JEly613/FPGA-Logic-Analyzer/sims/README.md

## Digital Channel Structure

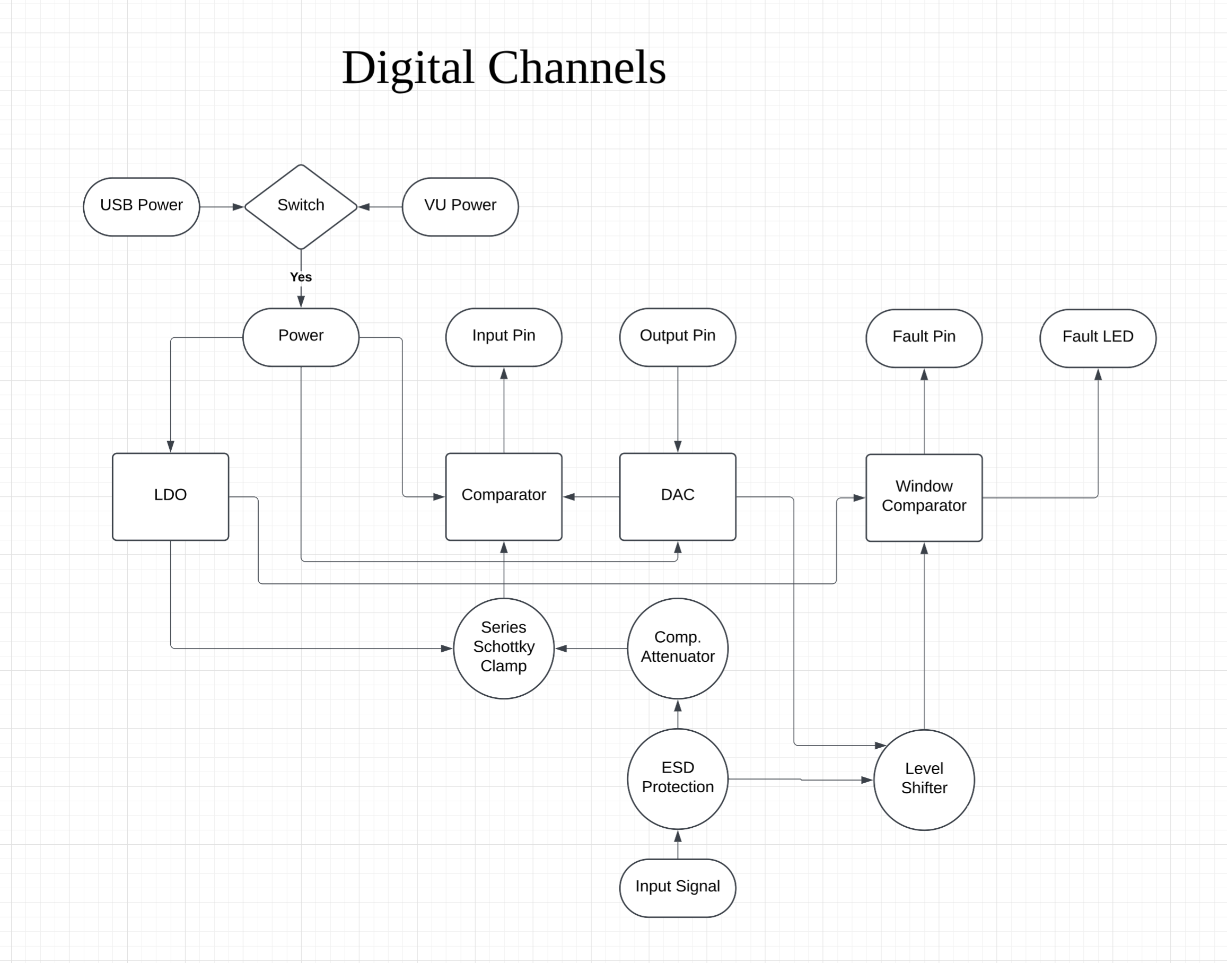
[picture p1: sims/image-2.png]


## Compensated Attenuator

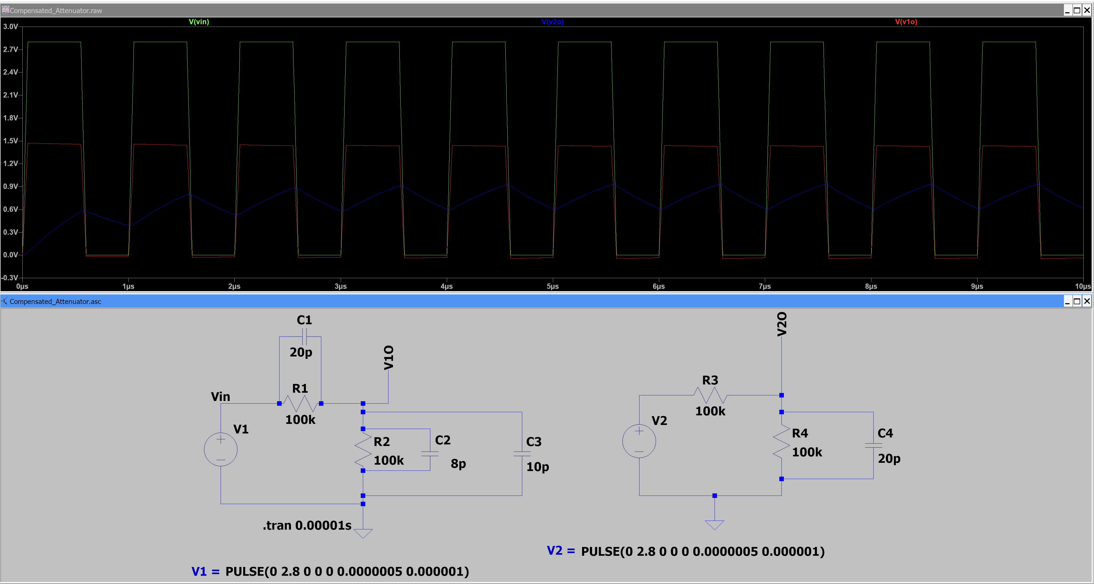
[picture p2: sims/image-4.png]


## Series Clamp

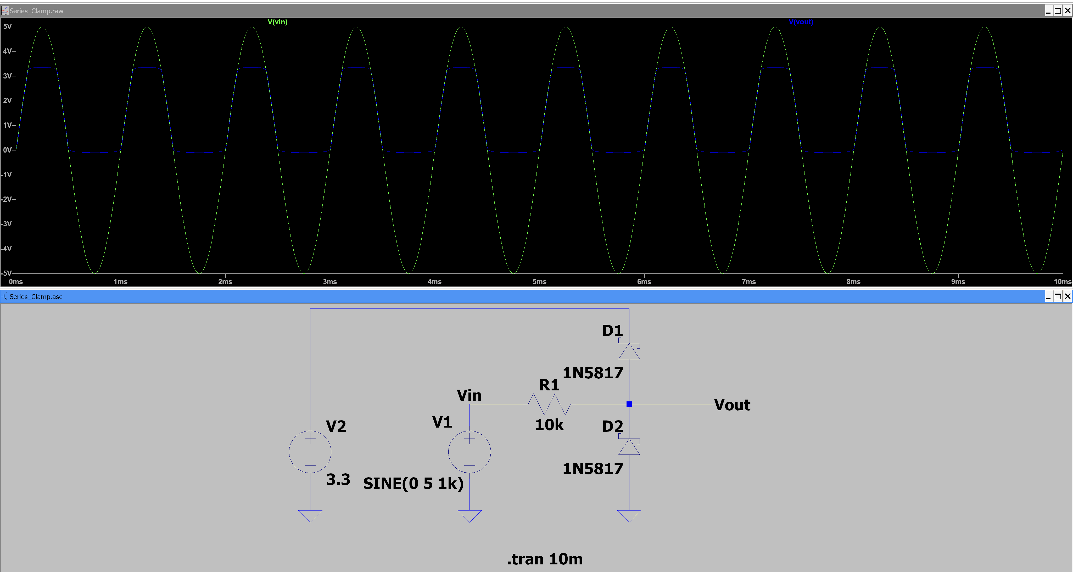
[picture p3: sims/image.png]


## Fault Detection

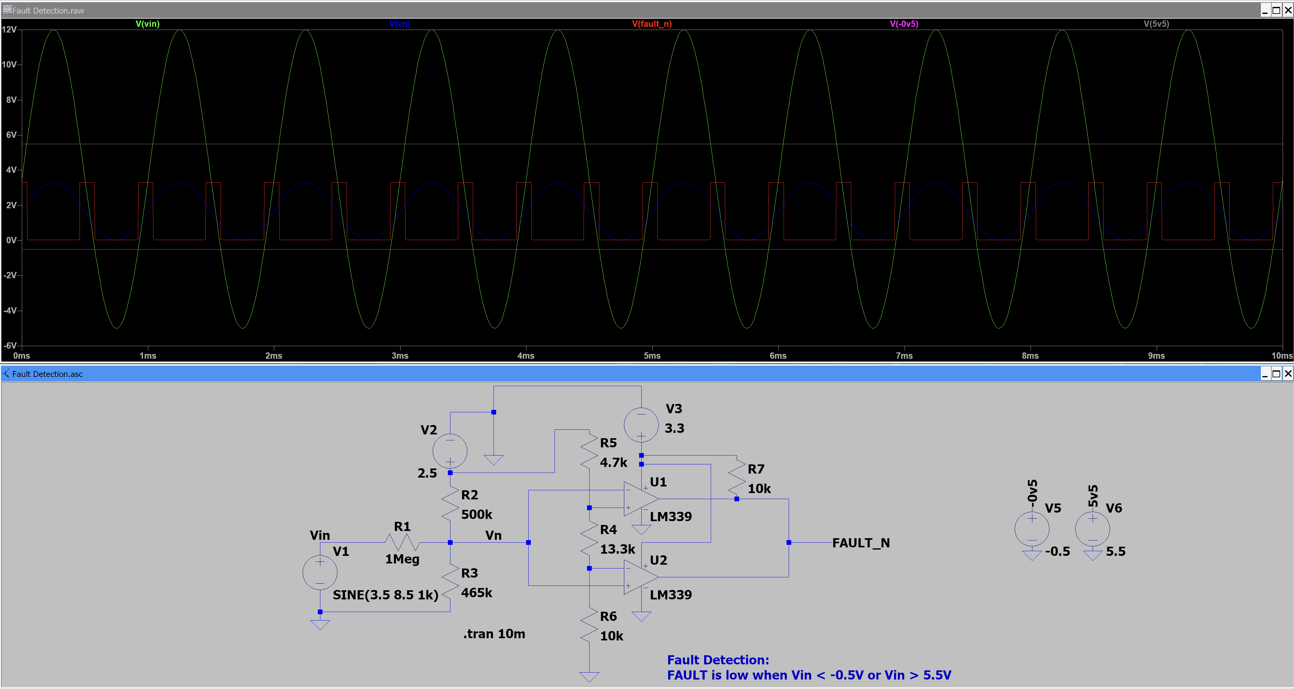
[picture p4: sims/image-1.png]
