JEly613/FPGA-Logic-Analyzer/sims/image-3.png

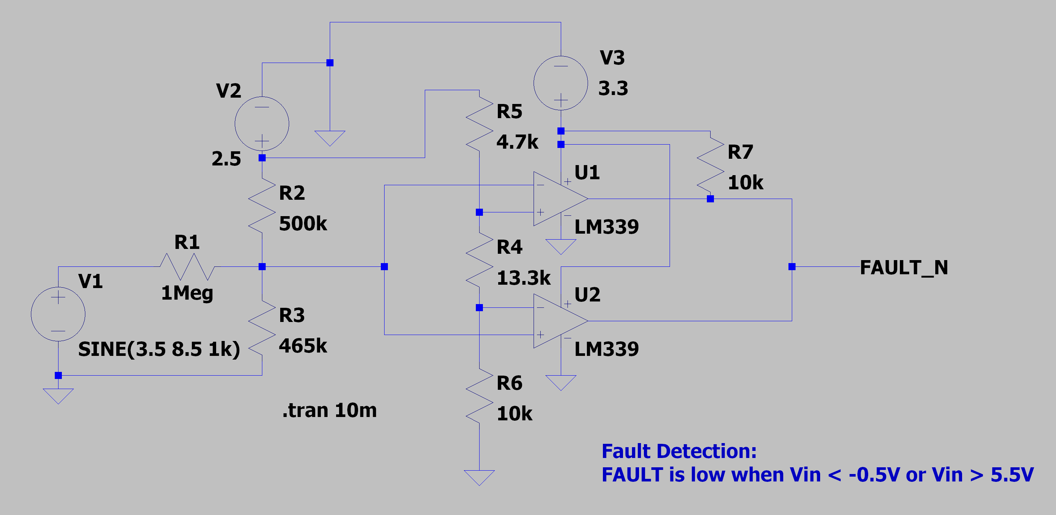
sims/image-3.png
