JEly613/FPGA-Logic-Analyzer/pcb/Analog_Front_End/AFE_3dmodels/JZ100.stp

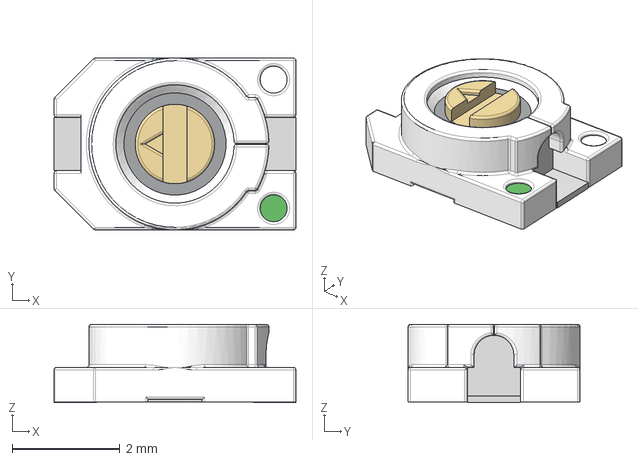
[picture p7: CAD file, 2026-10-25]
pcb/Analog_Front_End/AFE_3dmodels/JZ100.stp
4.50 x 3.20 x 1.46 mm
