JEly613/FPGA-Logic-Analyzer/sims/Op_amp_testing.asc

R1: res; 10k
R2: res; 10k
U2: OP400
V1: voltage; 50
V2: voltage; 2
Named nets: 0
.tran 0 1ms 0
