JEly613/FPGA-Logic-Analyzer/sims/AFE Testing.asc

C1: cap; 20p
C2: cap; 8p
C3: cap; 10p
C4: cap; 20p
R1: res; 100k
R2: res; 100k
R3: res; 100k
R4: res; 100k
V1: voltage; PULSE(0 2.8 0 0 0 0.0000005 0.000001)
V2: voltage; PULSE(0 2.8 0.0000003 0 0 0.0000005 0.000001)
Named nets: 0
.tran 0.00001s
