JEly613/FPGA-Logic-Analyzer/sims/Fault Detection.asc

R1: res; 1Meg
R2: res; 500k
R3: res; 465k
R4: res; 13.3k
R5: res; 4.7k
R6: res; 10k
R7: res; 10k
U1: LM339
U2: LM339
V1: voltage; SINE(3.5 8.5 1k)
V2: voltage; 2.5
V3: voltage; 3.3
V5: voltage; -0.5
V6: voltage; 5.5
Named nets: 0, FAULT_N, Vin, Vn, -0v5, 5v5
.tran 10m
Fault Detection:
FAULT is low when Vin < -0.5V or Vin > 5.5V
