JEly613/FPGA-Logic-Analyzer/sims/Series_Clamp.asc

D1: schottky; 1N5817
D2: schottky; 1N5817
R1: res; 10k
V1: voltage; SINE(0 5 1k)
V2: voltage; 3.3
Named nets: 0, Vin, Vout
.tran 10m
