JEly613/FPGA-Logic-Analyzer/pcb/Analog_Front_End/Analog_Front_End.kicad_pcb

## KiCad design pcb/Analog_Front_End/Analog_Front_End.kicad_pcb (2026-11-10)

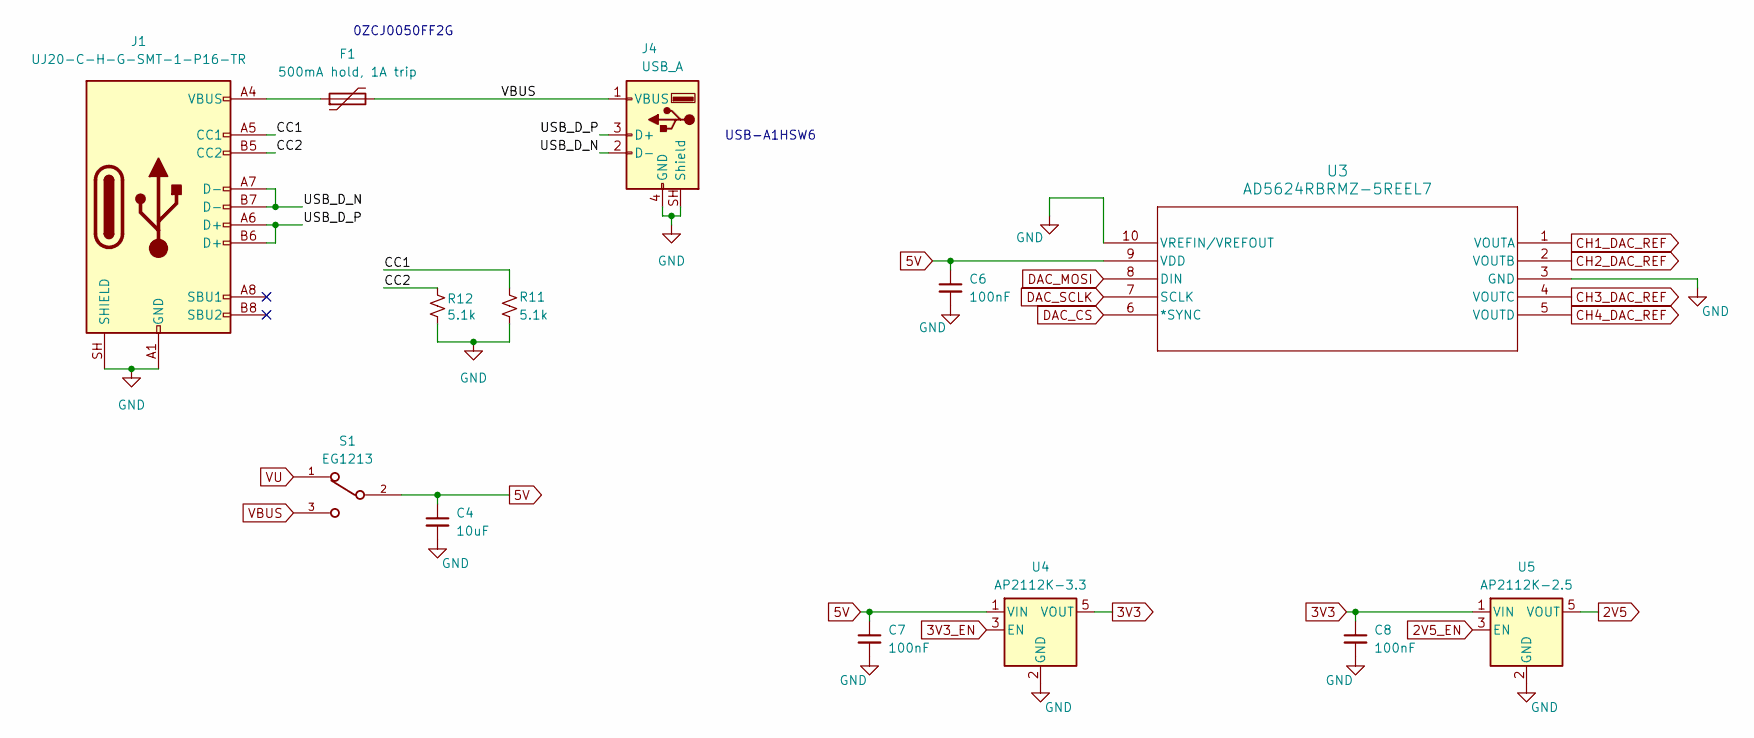
[picture p8: schematic PWR.kicad_sch]

Parts:
C4: 10uF; C_0603_1608Metric_Pad1.08x0.95mm_HandSolder
C6, C7, C8: 100nF; C_0603_1608Metric_Pad1.08x0.95mm_HandSolder
F1: 500mA hold, 1A trip; Fuse_1206_3216Metric_Pad1.42x1.75mm_HandSolder
J1: UJ20-C-H-G-SMT-1-P16-TR; SAMESKY_UJ20-C-H-G-SMT-1-P16-TR
J4: USB_A; CONN_USB-A1HSW6_OST
R11, R12: 5.1k; R_0603_1608Metric_Pad0.98x0.95mm_HandSolder
S1: EG1213; SW_EG1213; DigiKey_Part_Number EG1906-ND
U3: AD5624RBRMZ-5REEL7; RM_10_ADI-L
U4: AP2112K-3.3; SOT-23-5
U5: AP2112K-2.5; SOT-23-5

Connections:
2V5: U5.5 (VOUT); also elsewhere on the board
2V5_EN: U5.3 (EN); also elsewhere on the board
3V3: C8.1, U4.5 (VOUT), U5.1 (VIN); also elsewhere on the board
3V3_EN: U4.3 (EN); also elsewhere on the board
5V: C4.1, C6.1, C7.1, S1.2, U3.9 (VDD), U4.1 (VIN); also elsewhere on the board
/PWR/CC1: J1.A5 (CC1), R11.2
/PWR/CC2: J1.B5 (CC2), R12.2
/PWR/USB_D_N: J1.A7 (D-), J1.B7 (D-), J4.2 (D-)
/PWR/USB_D_P: J1.A6 (D+), J1.B6 (D+), J4.3 (D+)
CH1_DAC_REF: U3.1 (VOUTA); also elsewhere on the board
CH2_DAC_REF: U3.2 (VOUTB); also elsewhere on the board
CH3_DAC_REF: U3.4 (VOUTC); also elsewhere on the board
CH4_DAC_REF: U3.5 (VOUTD); also elsewhere on the board
DAC_CS: U3.6 (*SYNC); also elsewhere on the board
DAC_MOSI: U3.8 (DIN); also elsewhere on the board
DAC_SCLK: U3.7 (SCLK); also elsewhere on the board
GND: C4.2, C6.2, C7.2, C8.2, J1.A1 (GND), J1.A12 (GND), J1.B1 (GND), J1.B12 (GND), J1.SH (SHIELD), J4.4 (GND), J4.SH (Shield), R11.1, R12.1, U3.3 (GND), U3.10 (VREFIN/VREFOUT), U4.2 (GND), U5.2 (GND); also elsewhere on the board
unnamed: F1.1, J1.A4 (VBUS), J1.A9 (VBUS), J1.B4 (VBUS), J1.B9 (VBUS)
VBUS: F1.2, J4.1 (VBUS), S1.3
VU: S1.1; also elsewhere on the board

Notes on the sheet:
0ZCJ0050FF2G
USB-A1HSW6

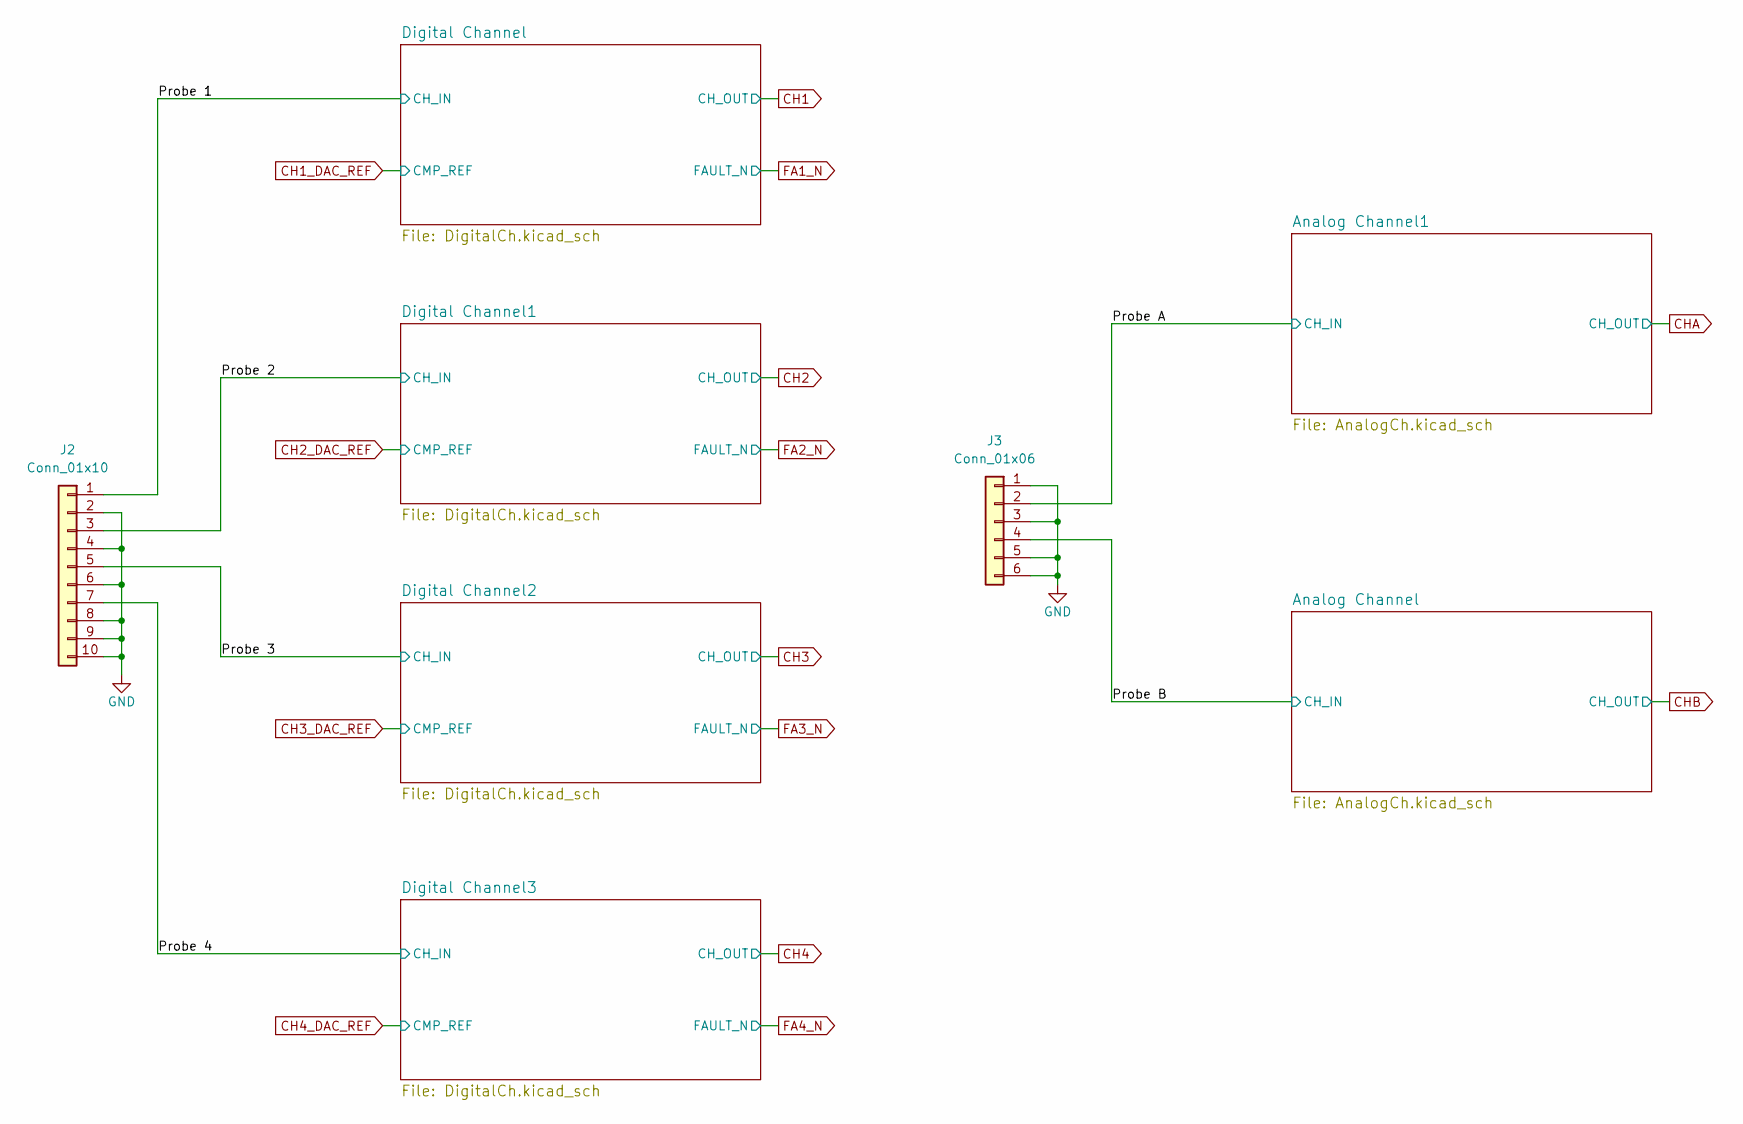
[picture p9: schematic AFE.kicad_sch]

Parts:
J2: Conn_01x10; BoxHeader_2x05_P2.54mm_Horizontal
J3: Conn_01x06; BoxHeader_2x03_P2.54mm_Horizontal

Connections:
/AFE/Probe 1: J2.1; also elsewhere on the board
/AFE/Probe 2: J2.3; also elsewhere on the board
/AFE/Probe 3: J2.5; also elsewhere on the board
/AFE/Probe 4: J2.7; also elsewhere on the board
/AFE/Probe A: J3.2; also elsewhere on the board
/AFE/Probe B: J3.4; also elsewhere on the board
GND: J2.2, J2.4, J2.6, J2.8, J2.9, J2.10, J3.1, J3.3, J3.5, J3.6; also elsewhere on the board

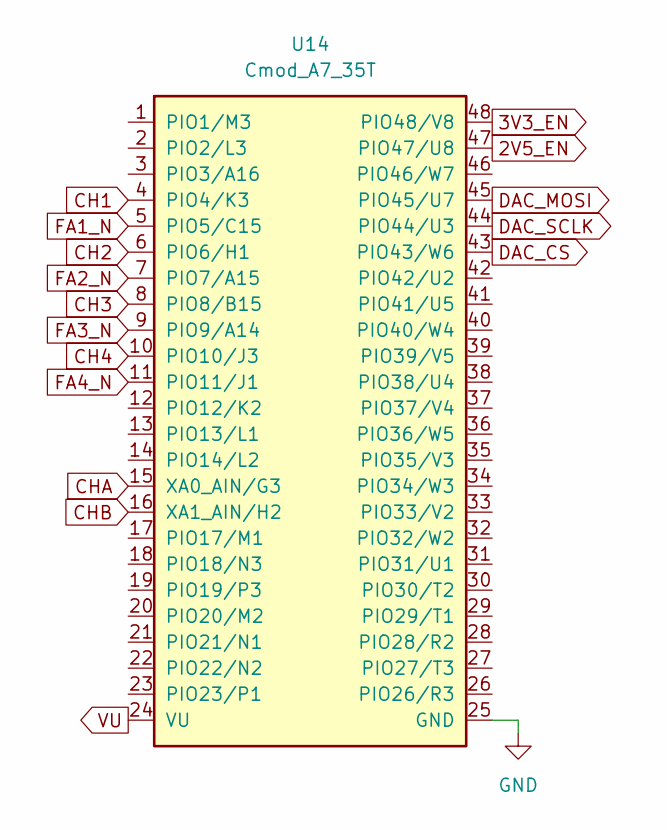
[picture p10: schematic FPGA.kicad_sch]

Parts:
U14: Cmod_A7_35T; Cmod_A7_DIP48_W15.24mm_Socket; MPN 410-328-35

Connections:
2V5_EN: U14.47 (PIO47/U8); also elsewhere on the board
3V3_EN: U14.48 (PIO48/V8); also elsewhere on the board
CH1: U14.4 (PIO4/K3); also elsewhere on the board
CH2: U14.6 (PIO6/H1); also elsewhere on the board
CH3: U14.8 (PIO8/B15); also elsewhere on the board
CH4: U14.10 (PIO10/J3); also elsewhere on the board
CHA: U14.15 (XA0_AIN/G3); also elsewhere on the board
CHB: U14.16 (XA1_AIN/H2); also elsewhere on the board
DAC_CS: U14.43 (PIO43/W6); also elsewhere on the board
DAC_MOSI: U14.45 (PIO45/U7); also elsewhere on the board
DAC_SCLK: U14.44 (PIO44/U3); also elsewhere on the board
FA1_N: U14.5 (PIO5/C15); also elsewhere on the board
FA2_N: U14.7 (PIO7/A15); also elsewhere on the board
FA3_N: U14.9 (PIO9/A14); also elsewhere on the board
FA4_N: U14.11 (PIO11/J1); also elsewhere on the board
GND: U14.25 (GND); also elsewhere on the board
VU: U14.24 (VU); also elsewhere on the board

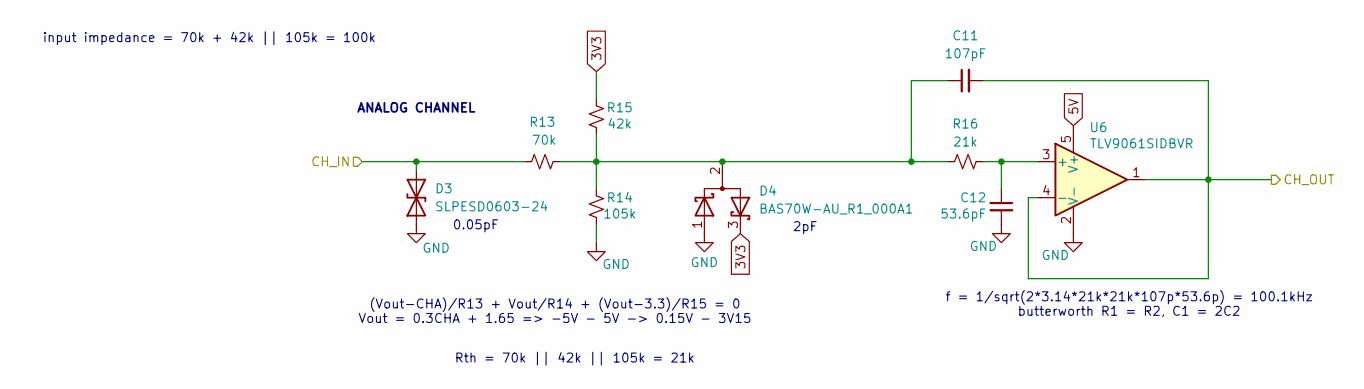
[picture p11: schematic AnalogCh.kicad_sch]

Parts:
C11: 107pF; C_0603_1608Metric_Pad1.08x0.95mm_HandSolder
C12: 53.6pF; C_0603_1608Metric_Pad1.08x0.95mm_HandSolder
D3: SLPESD0603-24; D_0603_1608Metric_Pad1.05x0.95mm_HandSolder
D4: BAS70W-AU_R1_000A1; SOT-323_SC-70
R13: 70k; R_0603_1608Metric_Pad0.98x0.95mm_HandSolder
R14: 105k; R_0603_1608Metric_Pad0.98x0.95mm_HandSolder
R15: 42k; R_0603_1608Metric_Pad0.98x0.95mm_HandSolder
R16: 21k; R_0603_1608Metric_Pad0.98x0.95mm_HandSolder
U6: TLV9061SIDBVR; SOT-23-5

Connections:
3V3: D4.3 (K), R15.1; also elsewhere on the board
5V: U6.5 (V+); also elsewhere on the board
/AFE/Probe B: D3.2 (A2), R13.1; also elsewhere on the board
CHB: C11.2, U6.1, U6.4 (-); also elsewhere on the board
GND: C12.2, D3.1 (A1), D4.1 (K), R14.2, U6.2 (V-); also elsewhere on the board
unnamed: C11.1, D4.2 (A), R13.2, R14.1, R15.2, R16.1
unnamed: C12.1, R16.2, U6.3 (+)

Parts of its further copies:
C23: 107pF; C_0603_1608Metric_Pad1.08x0.95mm_HandSolder
C24: 53.6pF; C_0603_1608Metric_Pad1.08x0.95mm_HandSolder
D11: SLPESD0603-24; D_0603_1608Metric_Pad1.05x0.95mm_HandSolder
D12: BAS70W-AU_R1_000A1; SOT-323_SC-70
R47: 70k; R_0603_1608Metric_Pad0.98x0.95mm_HandSolder
R48: 42k; R_0603_1608Metric_Pad0.98x0.95mm_HandSolder
R49: 105k; R_0603_1608Metric_Pad0.98x0.95mm_HandSolder
R50: 21k; R_0603_1608Metric_Pad0.98x0.95mm_HandSolder
U13: TLV9061SIDBVR; SOT-23-5

Connections of its further copies:
3V3: D12.3 (K), R48.1; also elsewhere on the board
5V: U13.5 (V+); also elsewhere on the board
/AFE/Probe A: D11.2 (A2), R47.1; also elsewhere on the board
CHA: C23.2, U13.1, U13.4 (-); also elsewhere on the board
GND: C24.2, D11.1 (A1), D12.1 (K), R49.2, U13.2 (V-); also elsewhere on the board
unnamed: C23.1, D12.2 (A), R47.2, R48.2, R49.1, R50.1
unnamed: C24.1, R50.2, U13.3 (+)

Notes on the sheet:
Rth = 70k || 42k || 105k = 21k
ANALOG CHANNEL
2pF
0.05pF
f = 1/sqrt(2*3.14*21k*21k*107p*53.6p) = 100.1kHz butterworth R1 = R2, C1 = 2C2
(Vout-CHA)/R13 + Vout/R14 + (Vout-3.3)/R15 = 0 Vout = 0.3CHA + 1.65 => -5V - 5V -> 0.15V - 3V15
input impedance = 70k + 42k || 105k = 100k

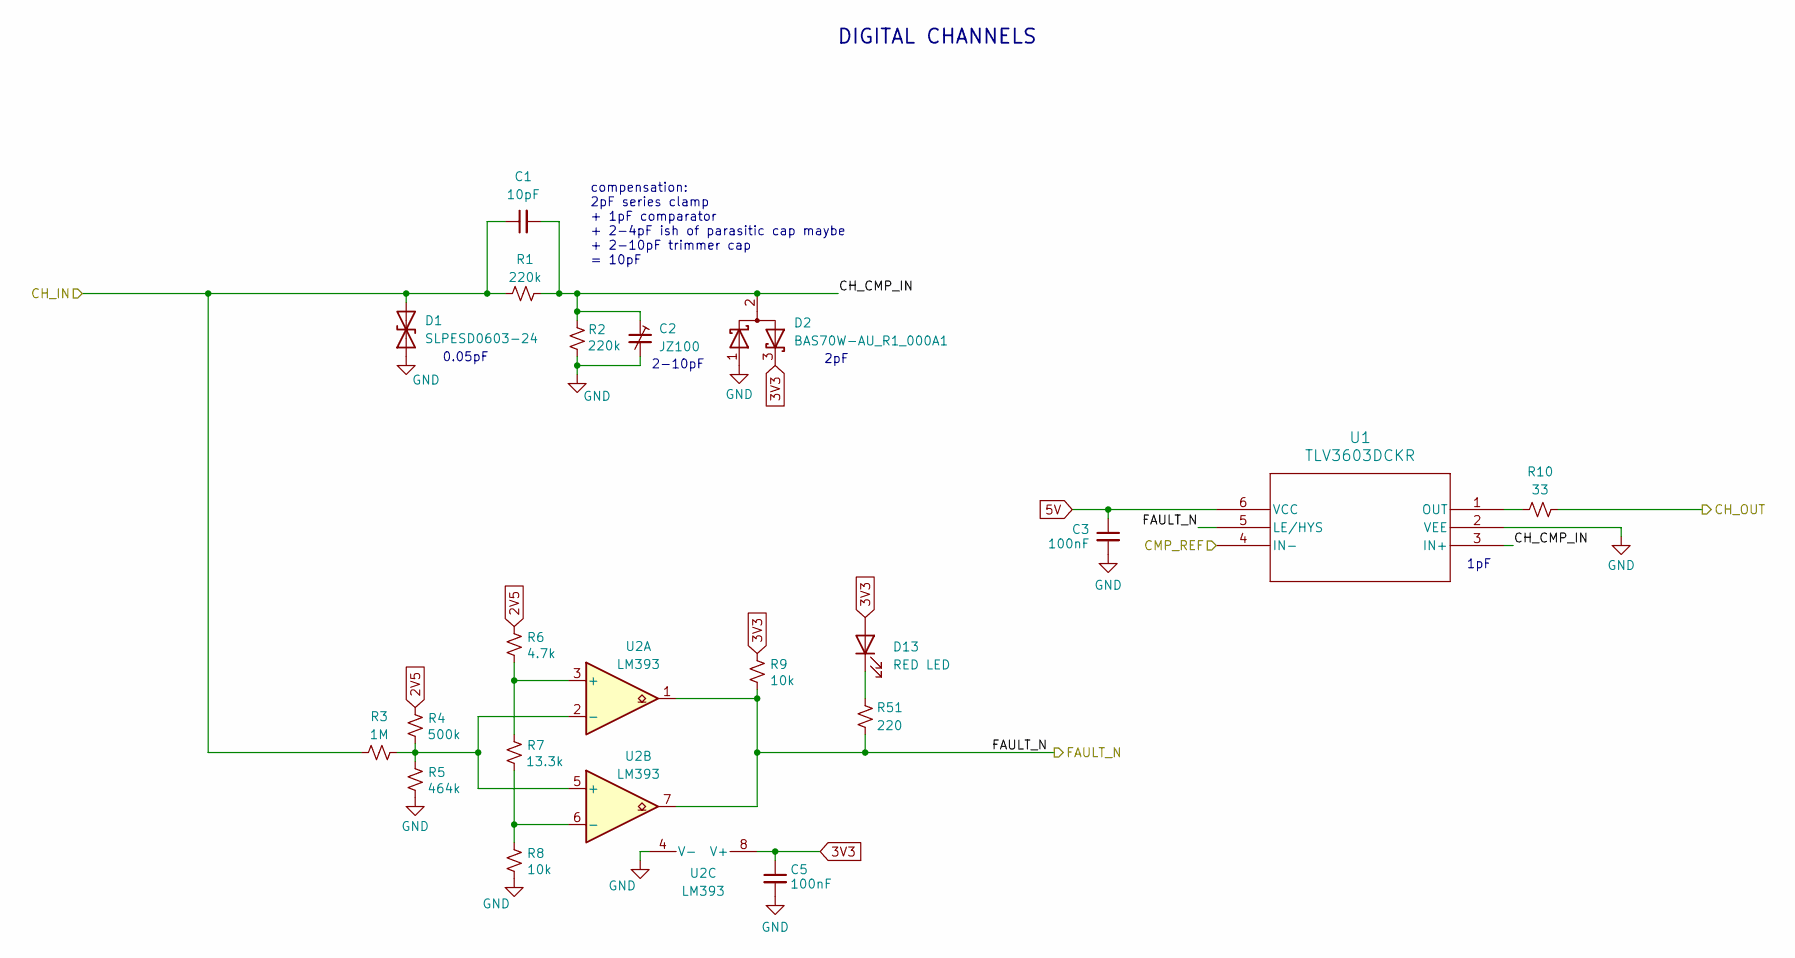
[picture p12: schematic DigitalCh.kicad_sch]

Parts:
C1: 10pF; C_0603_1608Metric_Pad1.08x0.95mm_HandSolder
C2: JZ100; C_0603_1608Metric_Pad1.08x0.95mm_HandSolder
C3, C5: 100nF; C_0603_1608Metric_Pad1.08x0.95mm_HandSolder
D1: SLPESD0603-24; D_0603_1608Metric_Pad1.05x0.95mm_HandSolder
D2: BAS70W-AU_R1_000A1; SOT-323_SC-70
D13: RED LED; LED_0805_2012Metric_Pad1.15x1.40mm_HandSolder
R1, R2: 220k; R_0603_1608Metric_Pad0.98x0.95mm_HandSolder
R3: 1M; R_0603_1608Metric_Pad0.98x0.95mm_HandSolder
R4: 500k; R_0603_1608Metric_Pad0.98x0.95mm_HandSolder
R5: 464k; R_0603_1608Metric_Pad0.98x0.95mm_HandSolder
R6: 4.7k; R_0603_1608Metric_Pad0.98x0.95mm_HandSolder
R7: 13.3k; R_0603_1608Metric_Pad0.98x0.95mm_HandSolder
R8, R9: 10k; R_0603_1608Metric_Pad0.98x0.95mm_HandSolder
R10: 33; R_0603_1608Metric_Pad0.98x0.95mm_HandSolder
R51: 220; R_0603_1608Metric_Pad0.98x0.95mm_HandSolder
U1: TLV3603DCKR; SC70_DCK_TEX
U2: LM393; LM393-L

Connections:
2V5: R4.1, R6.1; also elsewhere on the board
3V3: C5.1, D2.3 (K), D13.2 (A), R9.1, U2.8 (V+); also elsewhere on the board
5V: C3.1, U1.6 (VCC); also elsewhere on the board
/AFE/Digital Channel/CH_CMP_IN: C1.2, C2.1, D2.2 (A), R1.2, R2.1, U1.3 (IN+)
/AFE/Probe 1: C1.1, D1.2 (A2), R1.1, R3.1; also elsewhere on the board
CH1: R10.2; also elsewhere on the board
CH1_DAC_REF: U1.4 (IN-); also elsewhere on the board
FA1_N: R9.2, R51.2, U1.5 (LE/HYS), U2.1, U2.7; also elsewhere on the board
GND: C2.2, C3.2, C5.2, D1.1 (A1), D2.1 (K), R2.2, R5.2, R8.2, U1.2 (VEE), U2.4 (V-); also elsewhere on the board
unnamed: D13.1 (K), R51.1
unnamed: R10.1, U1.1 (OUT)
unnamed: R6.2, R7.1, U2.3 (+)
unnamed: R3.2, R4.2, R5.1, U2.2 (-), U2.5 (+)
unnamed: R7.2, R8.1, U2.6 (-)

Parts of its further copies:
C9, C15, C19: 10pF; C_0603_1608Metric_Pad1.08x0.95mm_HandSolder
C10, C16, C20: JZ100; C_0603_1608Metric_Pad1.08x0.95mm_HandSolder
C13, C14, C17, C18, C21, C22: 100nF; C_0603_1608Metric_Pad1.08x0.95mm_HandSolder
D5, D7, D9: SLPESD0603-24; D_0603_1608Metric_Pad1.05x0.95mm_HandSolder
D6, D8, D10: BAS70W-AU_R1_000A1; SOT-323_SC-70
D14, D15, D16: RED LED; LED_0805_2012Metric_Pad1.15x1.40mm_HandSolder
R17, R27, R37: 1M; R_0603_1608Metric_Pad0.98x0.95mm_HandSolder
R18, R28, R38: 500k; R_0603_1608Metric_Pad0.98x0.95mm_HandSolder
R19, R29, R39: 464k; R_0603_1608Metric_Pad0.98x0.95mm_HandSolder
R20, R30, R40: 4.7k; R_0603_1608Metric_Pad0.98x0.95mm_HandSolder
R21, R31, R41: 13.3k; R_0603_1608Metric_Pad0.98x0.95mm_HandSolder
R22, R25, R32, R35, R42, R45: 10k; R_0603_1608Metric_Pad0.98x0.95mm_HandSolder
R23, R24, R33, R34, R43, R44: 220k; R_0603_1608Metric_Pad0.98x0.95mm_HandSolder
R26, R36, R46: 33; R_0603_1608Metric_Pad0.98x0.95mm_HandSolder
R52, R53, R54: 220; R_0603_1608Metric_Pad0.98x0.95mm_HandSolder
U7, U9, U11: LM393; LM393-L
U8, U10, U12: TLV3603DCKR; SC70_DCK_TEX

Connections of its further copies:
2V5: R18.1, R20.1, R28.1, R30.1, R38.1, R40.1; also elsewhere on the board
3V3: C13.1, C17.1, C21.1, D6.3 (K), D8.3 (K), D10.3 (K), D14.2 (A), D15.2 (A), D16.2 (A), R25.1, R35.1, R45.1, U7.8 (V+), U9.8 (V+), U11.8 (V+); also elsewhere on the board
5V: C14.1, C18.1, C22.1, U8.6 (VCC), U10.6 (VCC), U12.6 (VCC); also elsewhere on the board
/AFE/Digital Channel1/CH_CMP_IN: C9.2, C10.1, D6.2 (A), R23.2, R24.1, U8.3 (IN+)
/AFE/Digital Channel2/CH_CMP_IN: C15.2, C16.1, D8.2 (A), R33.2, R34.1, U10.3 (IN+)
/AFE/Digital Channel3/CH_CMP_IN: C19.2, C20.1, D10.2 (A), R43.2, R44.1, U12.3 (IN+)
/AFE/Probe 2: C9.1, D5.2 (A2), R17.1, R23.1; also elsewhere on the board
/AFE/Probe 3: C15.1, D7.2 (A2), R27.1, R33.1; also elsewhere on the board
/AFE/Probe 4: C19.1, D9.2 (A2), R37.1, R43.1; also elsewhere on the board
CH2: R26.2; also elsewhere on the board
CH2_DAC_REF: U8.4 (IN-); also elsewhere on the board
CH3: R36.2; also elsewhere on the board
CH3_DAC_REF: U10.4 (IN-); also elsewhere on the board
CH4: R46.2; also elsewhere on the board
CH4_DAC_REF: U12.4 (IN-); also elsewhere on the board
FA2_N: R25.2, R52.2, U7.1, U7.7, U8.5 (LE/HYS); also elsewhere on the board
FA3_N: R35.2, R53.2, U9.1, U9.7, U10.5 (LE/HYS); also elsewhere on the board
FA4_N: R45.2, R54.2, U11.1, U11.7, U12.5 (LE/HYS); also elsewhere on the board
GND: C10.2, C13.2, C14.2, C16.2, C17.2, C18.2, C20.2, C21.2, C22.2, D5.1 (A1), D6.1 (K), D7.1 (A1), D8.1 (K), D9.1 (A1), D10.1 (K), R19.2, R22.2, R24.2, R29.2, R32.2, R34.2, R39.2, R42.2, R44.2, U7.4 (V-), U8.2 (VEE), U9.4 (V-), U10.2 (VEE), U11.4 (V-), U12.2 (VEE); also elsewhere on the board
unnamed: D14.1 (K), R52.1
unnamed: D15.1 (K), R53.1
unnamed: D16.1 (K), R54.1
unnamed: R20.2, R21.1, U7.3 (+)
unnamed: R17.2, R18.2, R19.1, U7.2 (-), U7.5 (+)
unnamed: R21.2, R22.1, U7.6 (-)
unnamed: R26.1, U8.1 (OUT)
unnamed: R30.2, R31.1, U9.3 (+)
unnamed: R27.2, R28.2, R29.1, U9.2 (-), U9.5 (+)
unnamed: R31.2, R32.1, U9.6 (-)
unnamed: R36.1, U10.1 (OUT)
unnamed: R40.2, R41.1, U11.3 (+)
unnamed: R37.2, R38.2, R39.1, U11.2 (-), U11.5 (+)
unnamed: R41.2, R42.1, U11.6 (-)
unnamed: R46.1, U12.1 (OUT)

Notes on the sheet:
1pF
0.05pF
2pF
DIGITAL CHANNELS
compensation: 2pF series clamp + 1pF comparator + 2-4pF ish of parasitic cap maybe + 2-10pF trimmer cap = 10pF
2-10pF

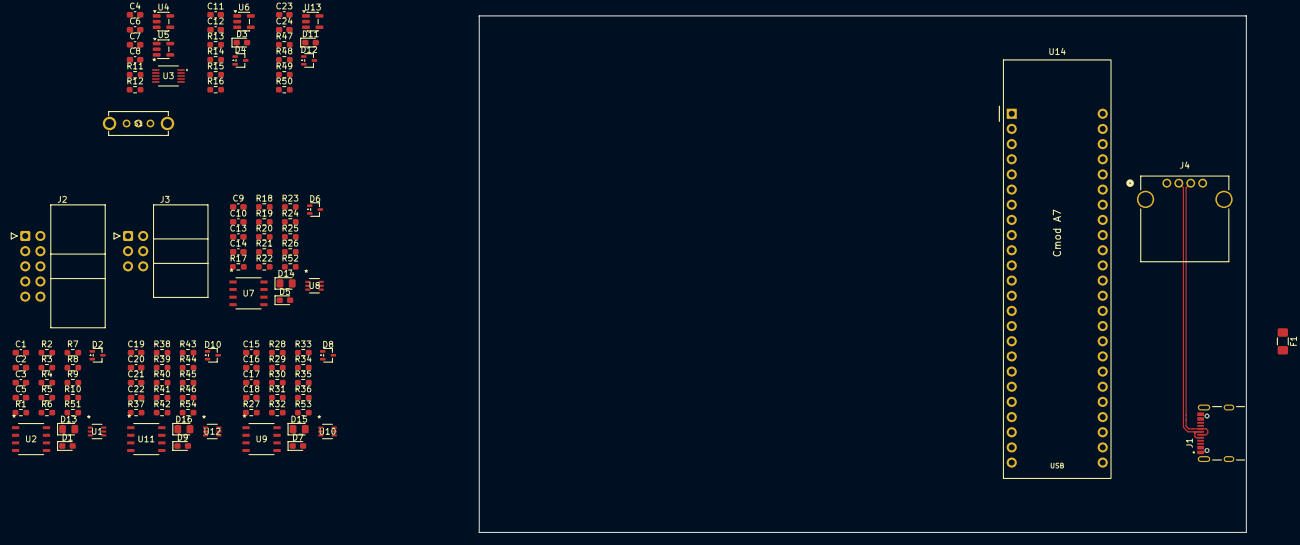
[picture p13: board Analog_Front_End.kicad_pcb from above]

Board: 4 copper layers, 128.5 x 86.5 mm, 114 parts (0 on the bottom side), 64 nets.
