JEly613/FPGA-Logic-Analyzer/(commit log)

2026-10-05 fault deteciton, series voltage clamp, op amp, and attenuator sims
2026-10-25 various changes, including power, channel logic, FPGA
2026-11-06 schematic complete
